sg-gupta/robotic-bionic-hand/(commit log)

2026-11-04 Add async pipeline for MANO angle display
    This file implements an async pipeline for displaying MANO angles for a bionic hand, including camera setup, angle extraction, and serial communication.
2026-11-04 Add robotic hand control implementation
    This file contains the implementation for controlling a robotic hand using servo motors. It includes setup for finger and wrist servos, as well as handling serial commands for movement.
2026-11-05 Add bionic hand control logic in stm_manual_hand.ino
    This file implements the control logic for a bionic hand, including finger and wrist movements, state management, and serial command handling.
